Nightshadow1258/HW_STM32F405_DRV8424P/Documentation/STM32F405_DRV8424P_3DView.png

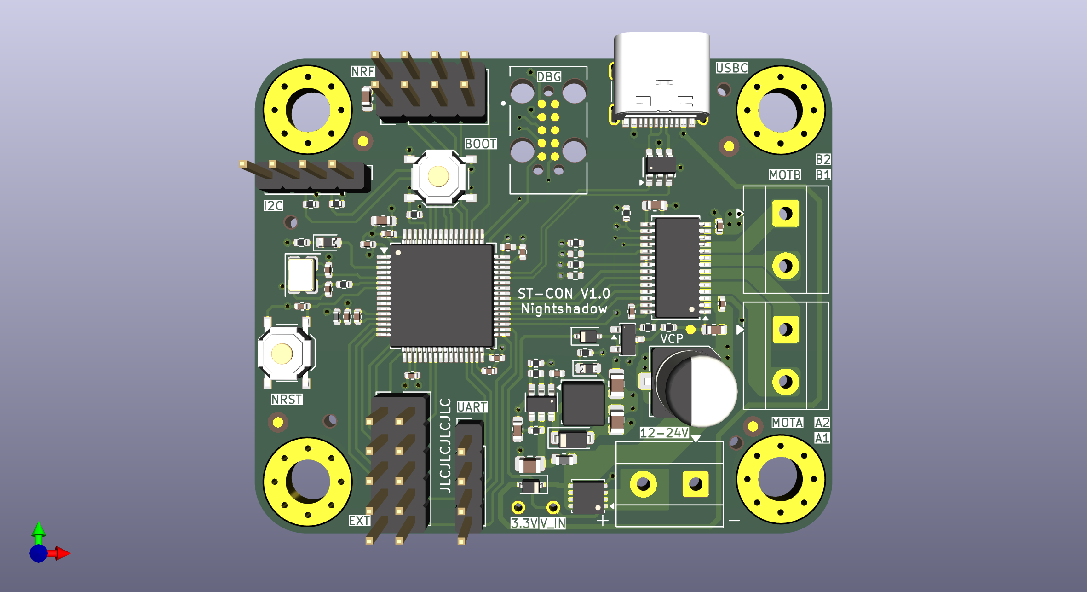
Documentation/STM32F405_DRV8424P_3DView.png
