Nightshadow1258/HW_STM32F405_DRV8424P/README.md

# STM32F405_DRV8424P
This project contains all files for a Stepper/2xDC-Motor Controller based on a STM32F405 MCU and a DRV8424P GDU.
