Nightshadow1258/HW_STM32F405_DRV8424P/Documentation/Plots/output/DRV8424_9V_(VM)_(A1).jpeg

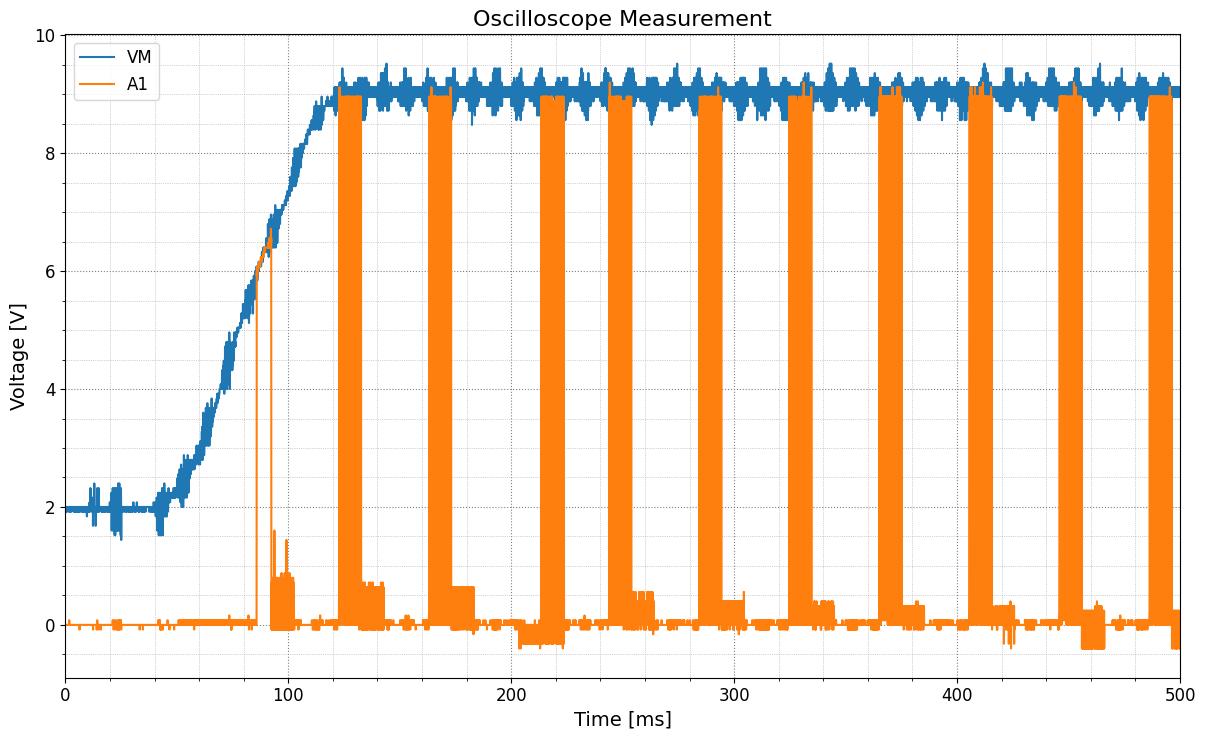
Documentation/Plots/output/DRV8424_9V_(VM)_(A1).jpeg
