Nightshadow1258/HW_STM32F405_DRV8424P/KiCAD/STM32F405_DRV8424P.step

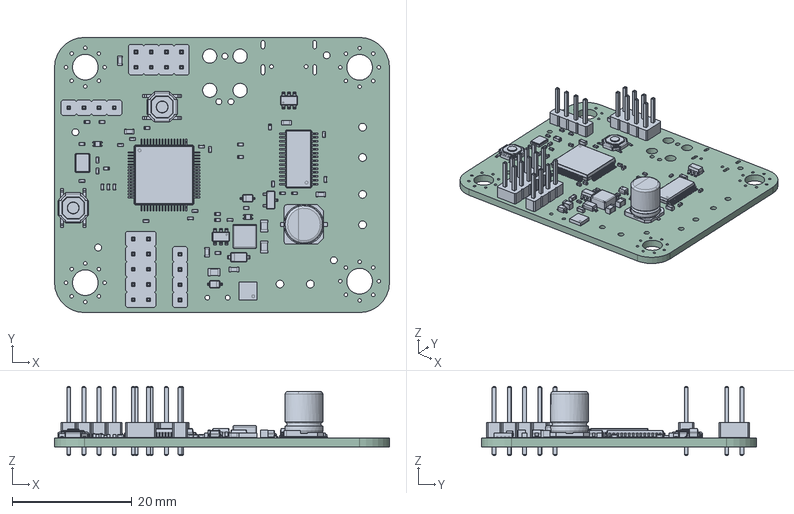
[picture p4: CAD file, 2026-08-23]
KiCAD/STM32F405_DRV8424P.step
56.0 x 46.0 x 11.5 mm
R_0402_1005Metric x 14
C_0603_1608Metric x 5
Crystal_SMD_3225-4Pin_3.2x2.5mm
C_0402_1005Metric x 16
DFN-8-1EP_3x3mm_P0.65mm_EP1.55x2.4mm
SOT-23-6 x 2
STM32F405_DRV8424P 1.11.1
PinHeader_2x05_P2.54mm_Vertical
L_0603_1608Metric
D_SOD-323 x 2
TS-1187A x 2
D_SOD-123
C_0805_2012Metric x 3
D_0603_1608Metric x 2
PinHeader_1x04_P2.54mm_Vertical x 2
CP_Elec_6.3x7.7
LQFP-64_10x10mm_P0.5mm
PinHeader_2x04_P2.54mm_Vertical
SOT-23
HTSSOP-28-1EP_4.4x9.7mm_P0.65mm_EP3.4x9.5mm
L_0402_1005Metric
STM32F405_DRV8424P_PCB
