Nightshadow1258/HW_STM32F405_DRV8424P/Documentation/Schematics/SCH_STM32F405_DRV8424P_V1.0.pdf

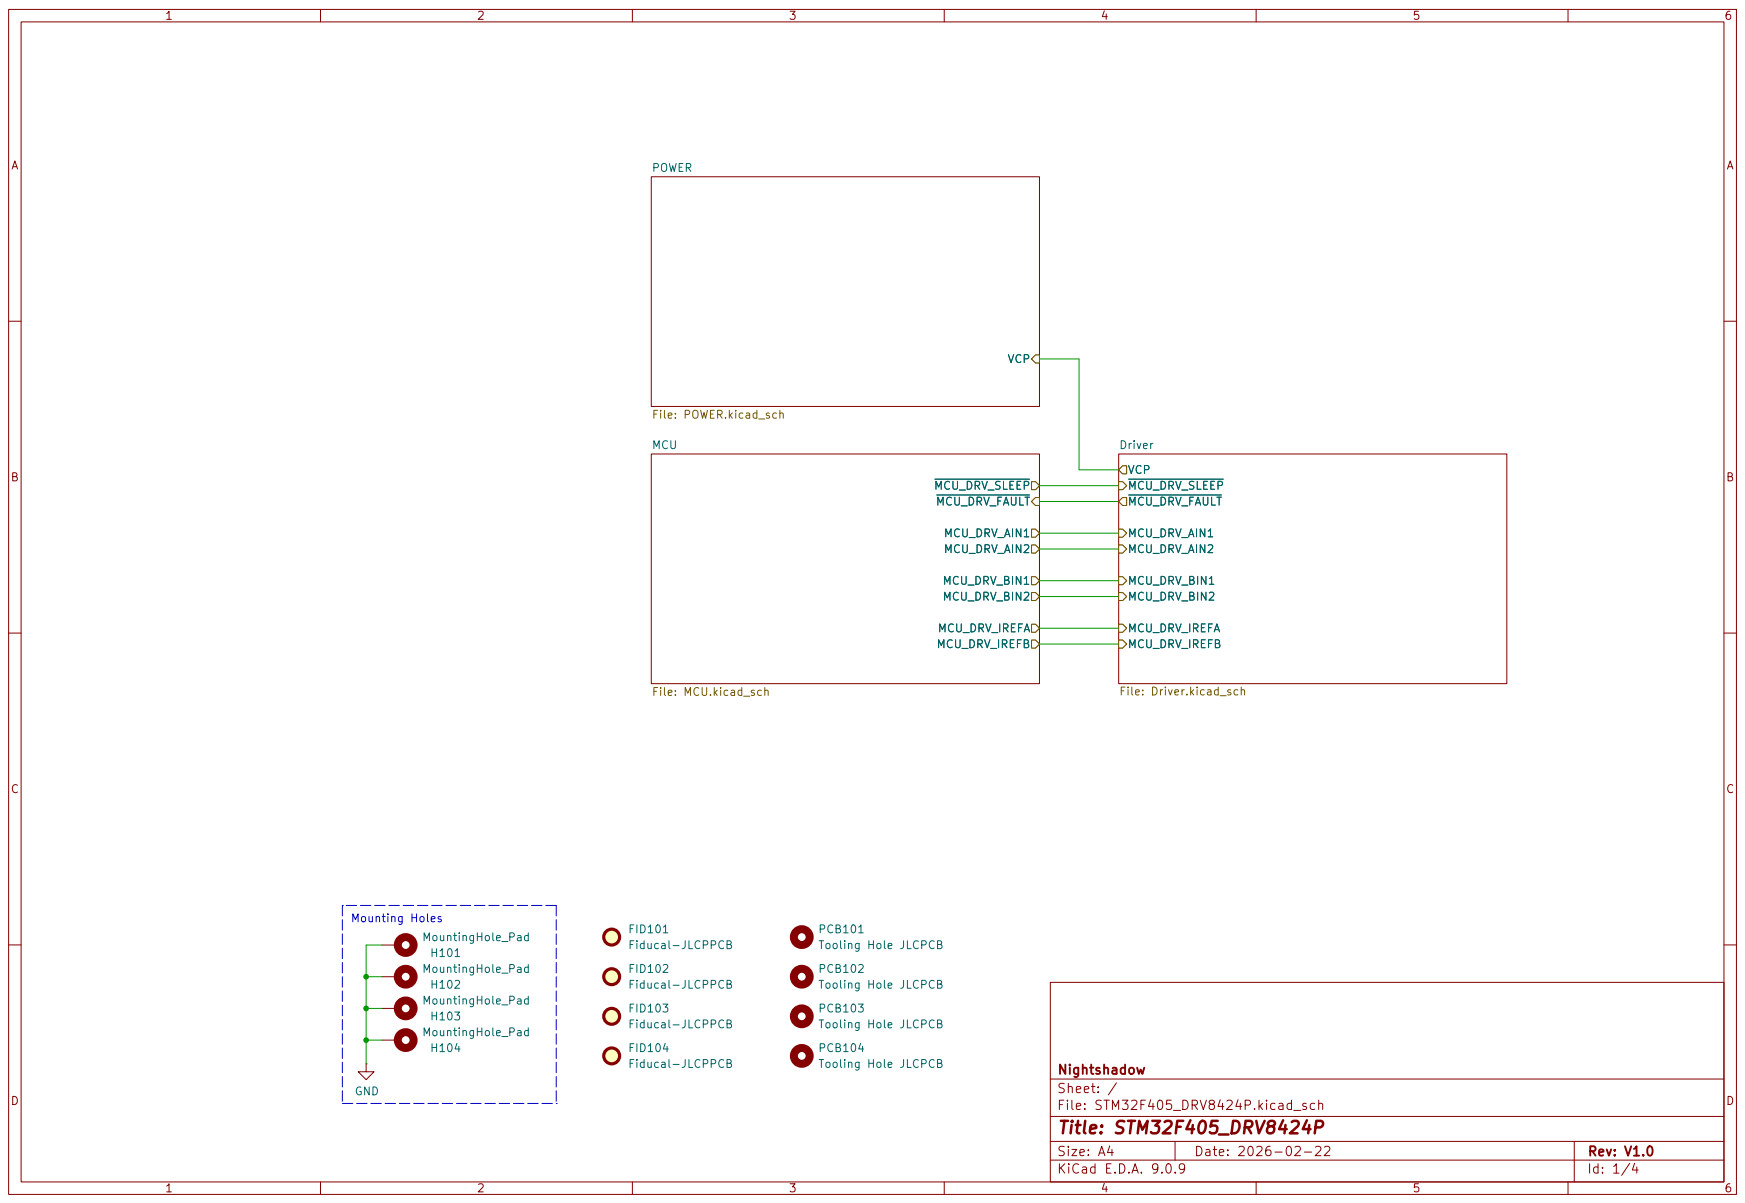
[picture p5: page 1]

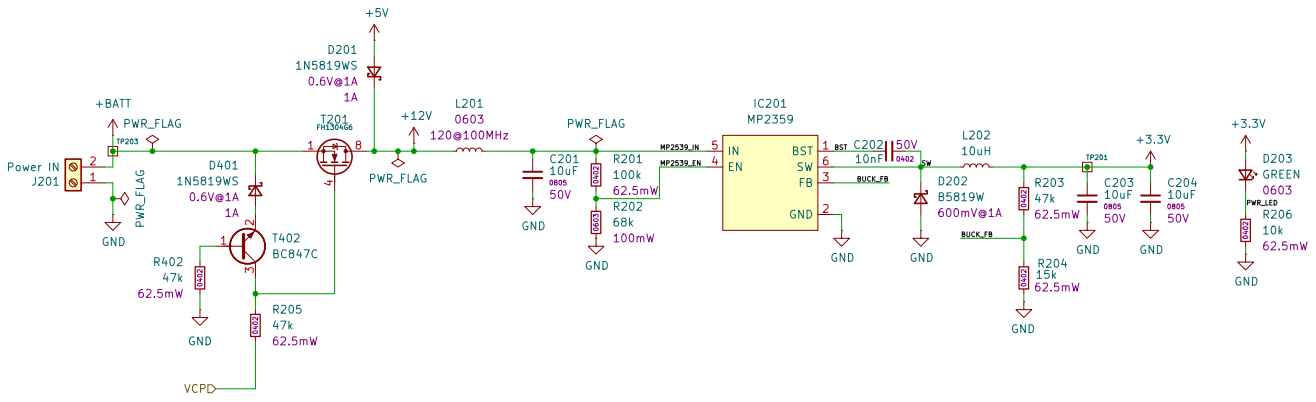
[picture p6: page 2]

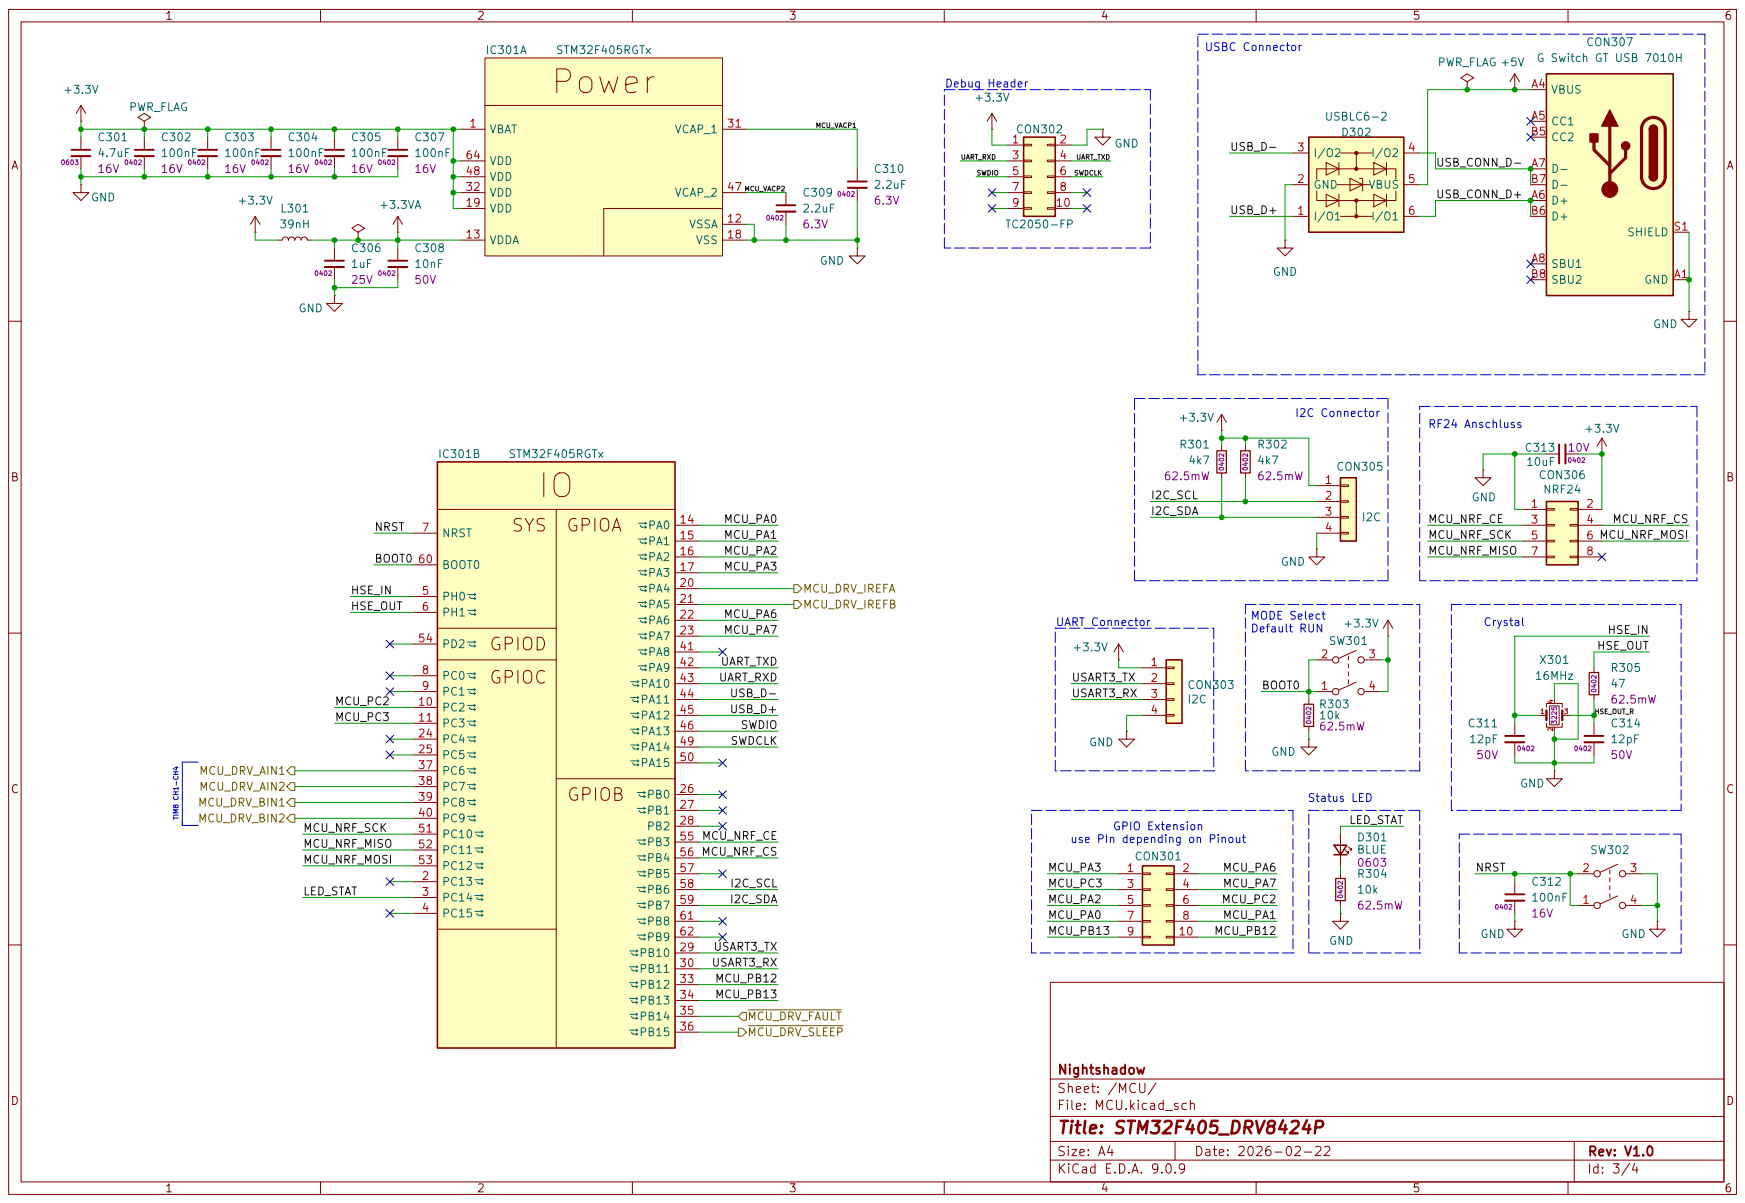
[picture p7: page 3]

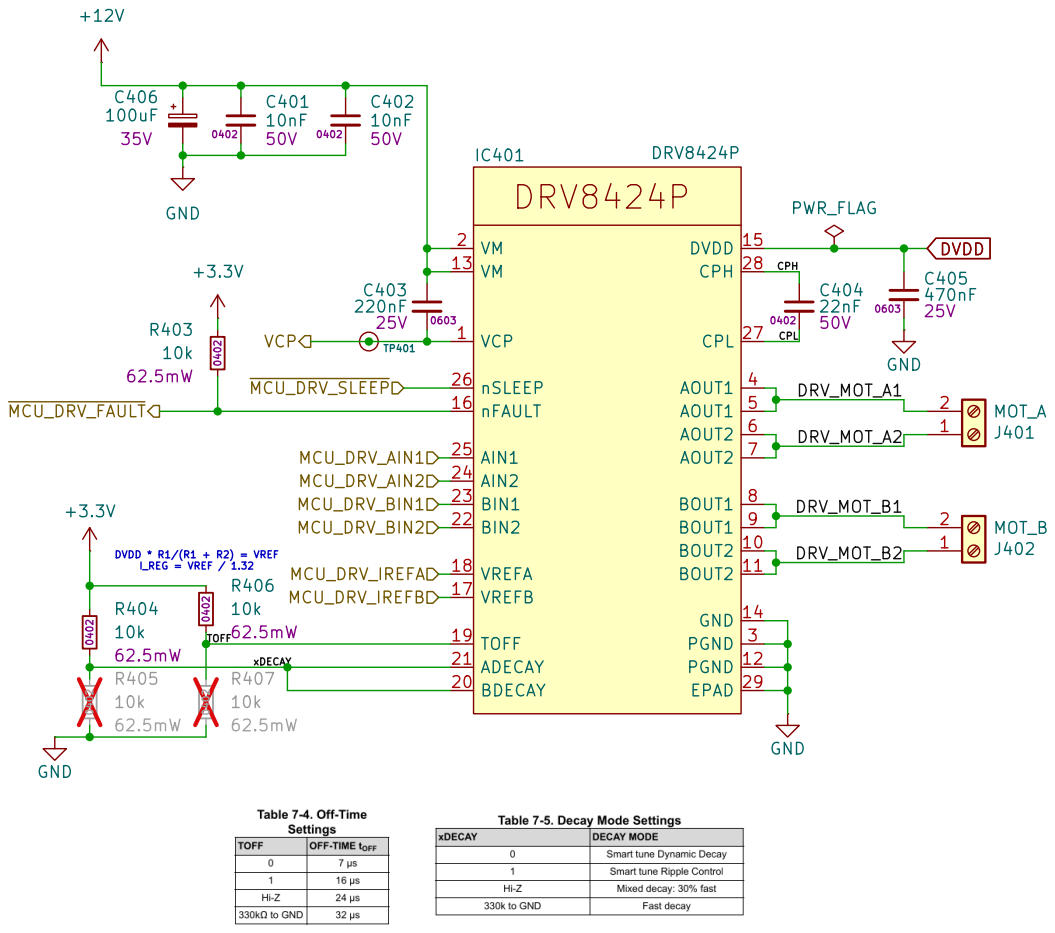
[picture p8: page 4]
