Nightshadow1258/HW_STM32F405_DRV8424P/Documentation/Plots/output/DRV8424_USBC5V_(VM)_(A1).pdf

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

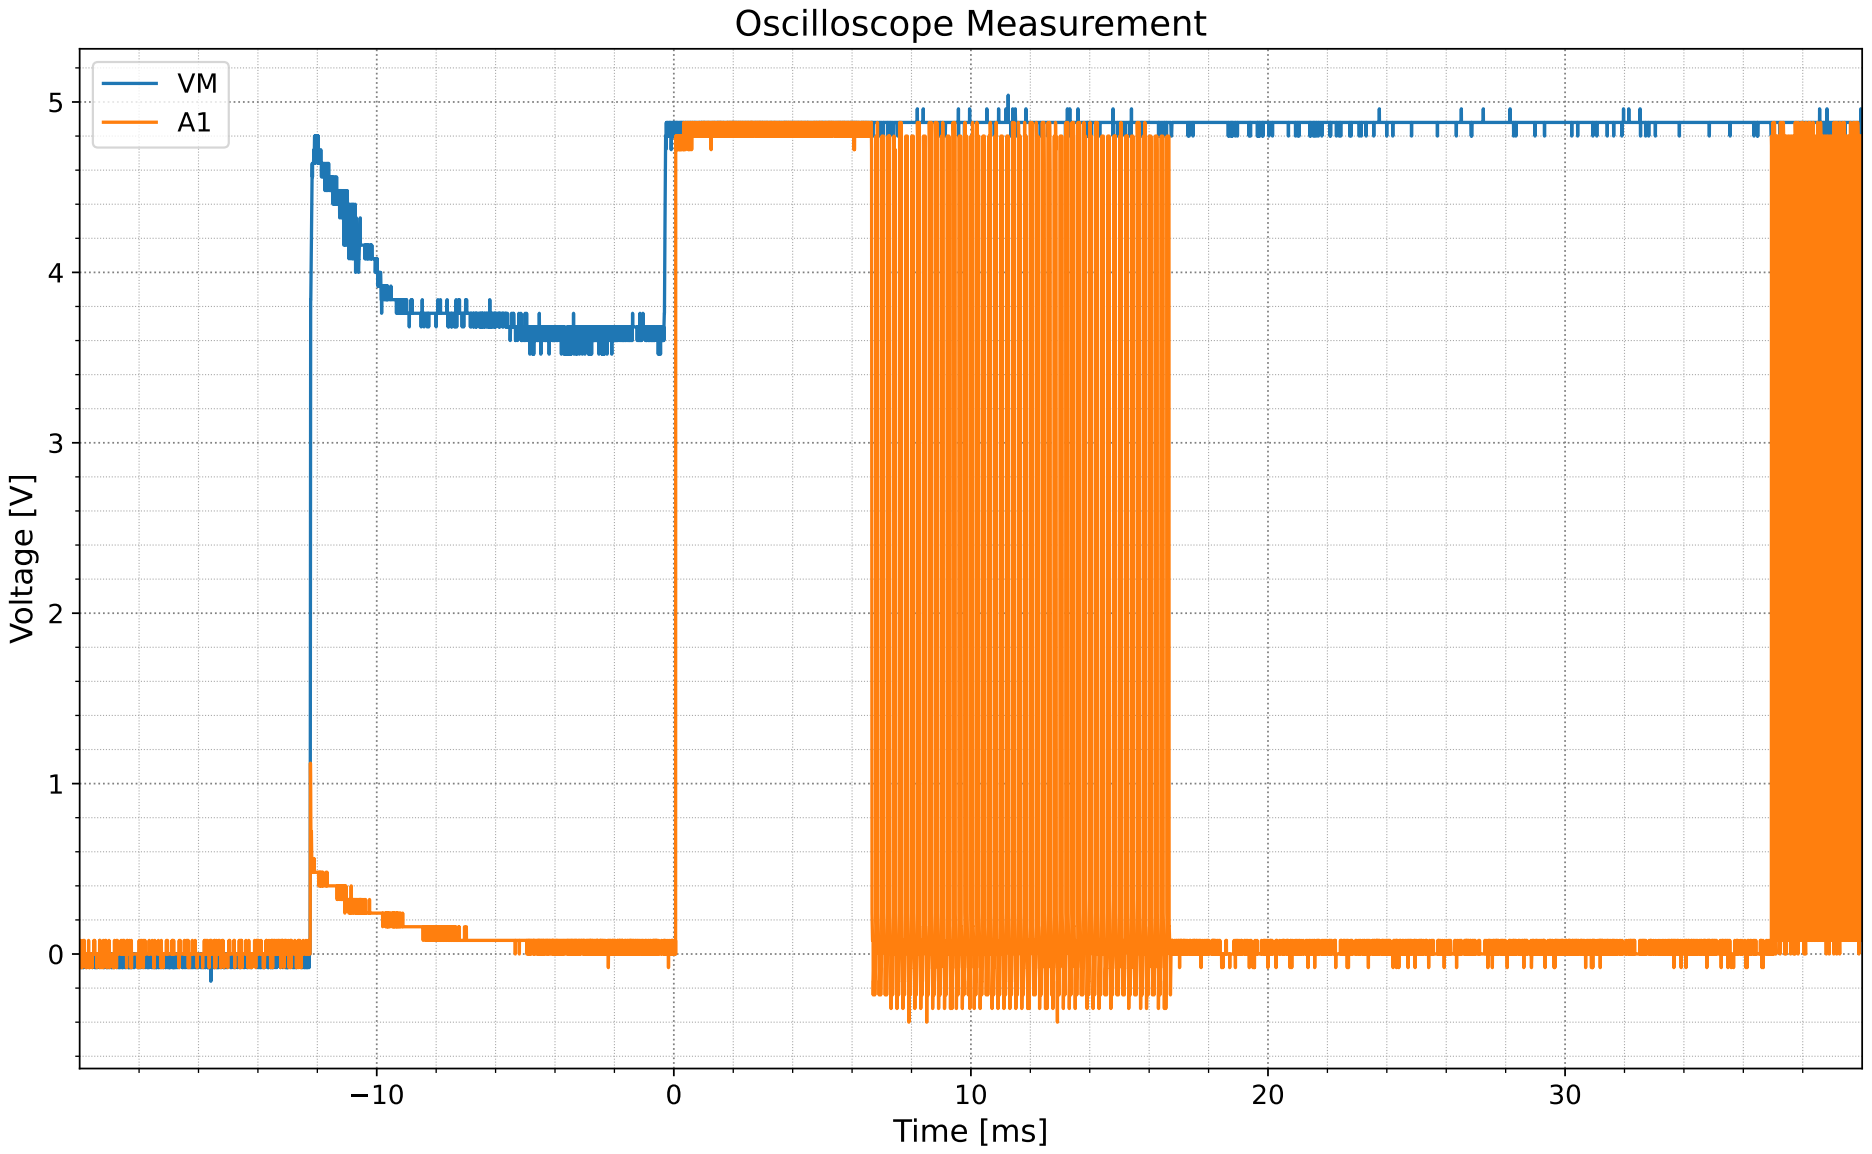
[picture p10: page 1]
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
