Nightshadow1258/HW_STM32F405_DRV8424P/KiCAD/STM32F405_DRV8424P.kicad_pcb

## KiCad design KiCAD/STM32F405_DRV8424P.kicad_pcb (2026-08-23)

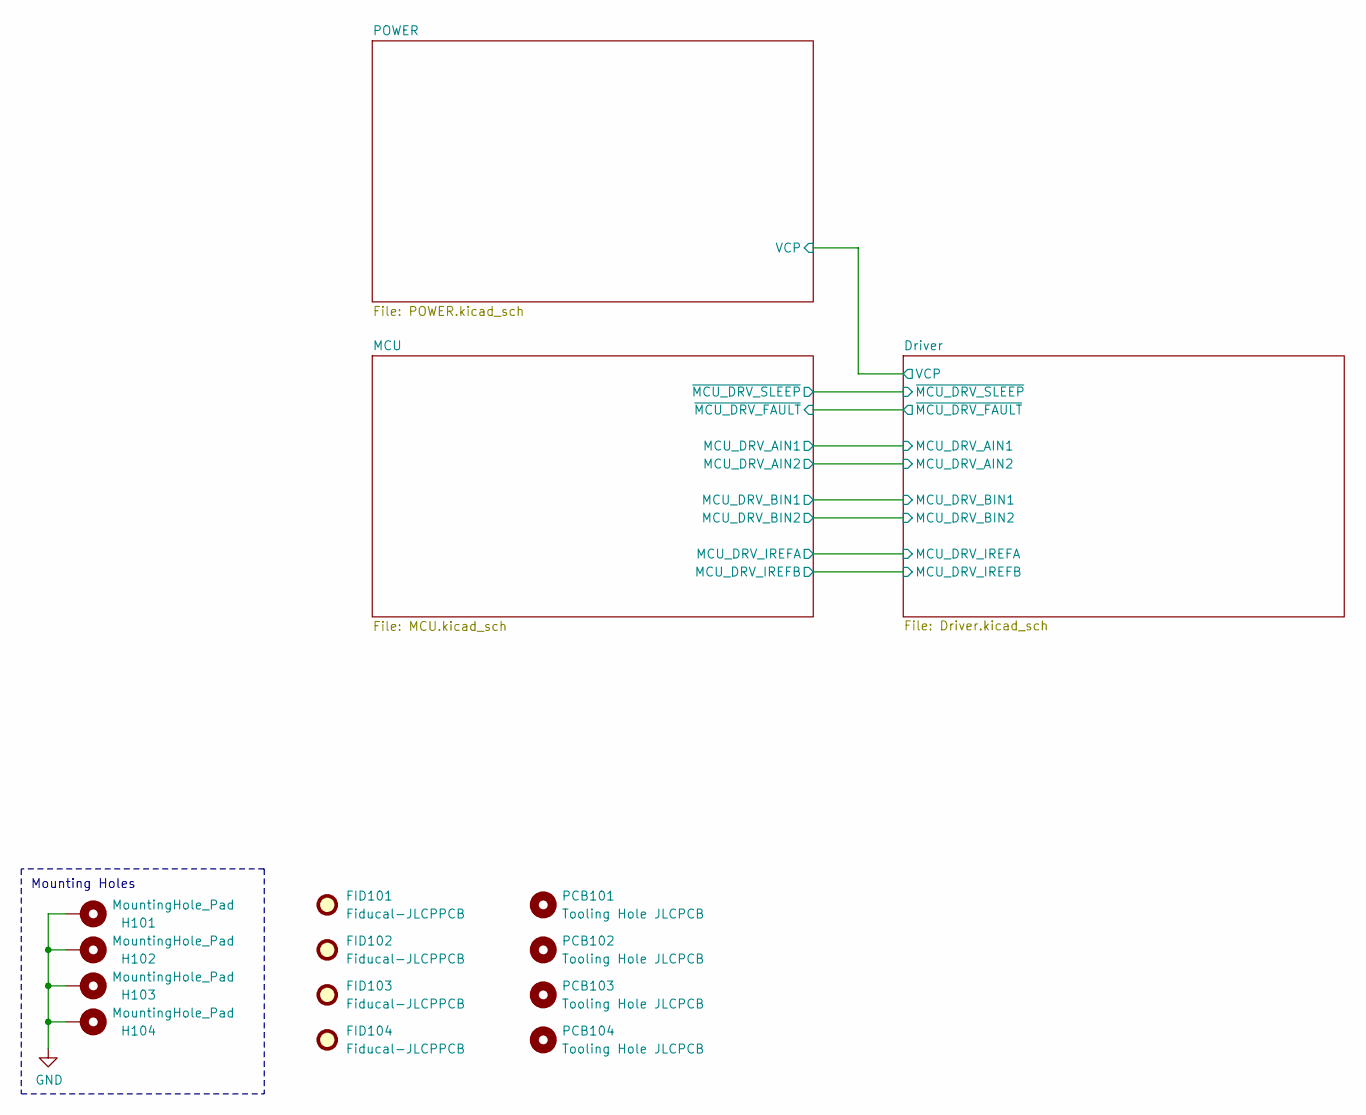
[picture p11: schematic STM32F405_DRV8424P.kicad_sch]

Parts:
FID101, FID102, FID103, FID104: Fiducal-JLCPPCB; PCB-FID-JLCPCB
H101, H102, H103, H104: MountingHole_Pad; MountingHole_4.3mm_M4_Pad_Via
PCB101, PCB102, PCB103, PCB104: Tooling Hole JLCPCB; PCB-NPTH-JLCPCB

Connections:
GND: H101.1, H102.1, H103.1, H104.1; also elsewhere on the board

Notes on the sheet:
Mounting Holes

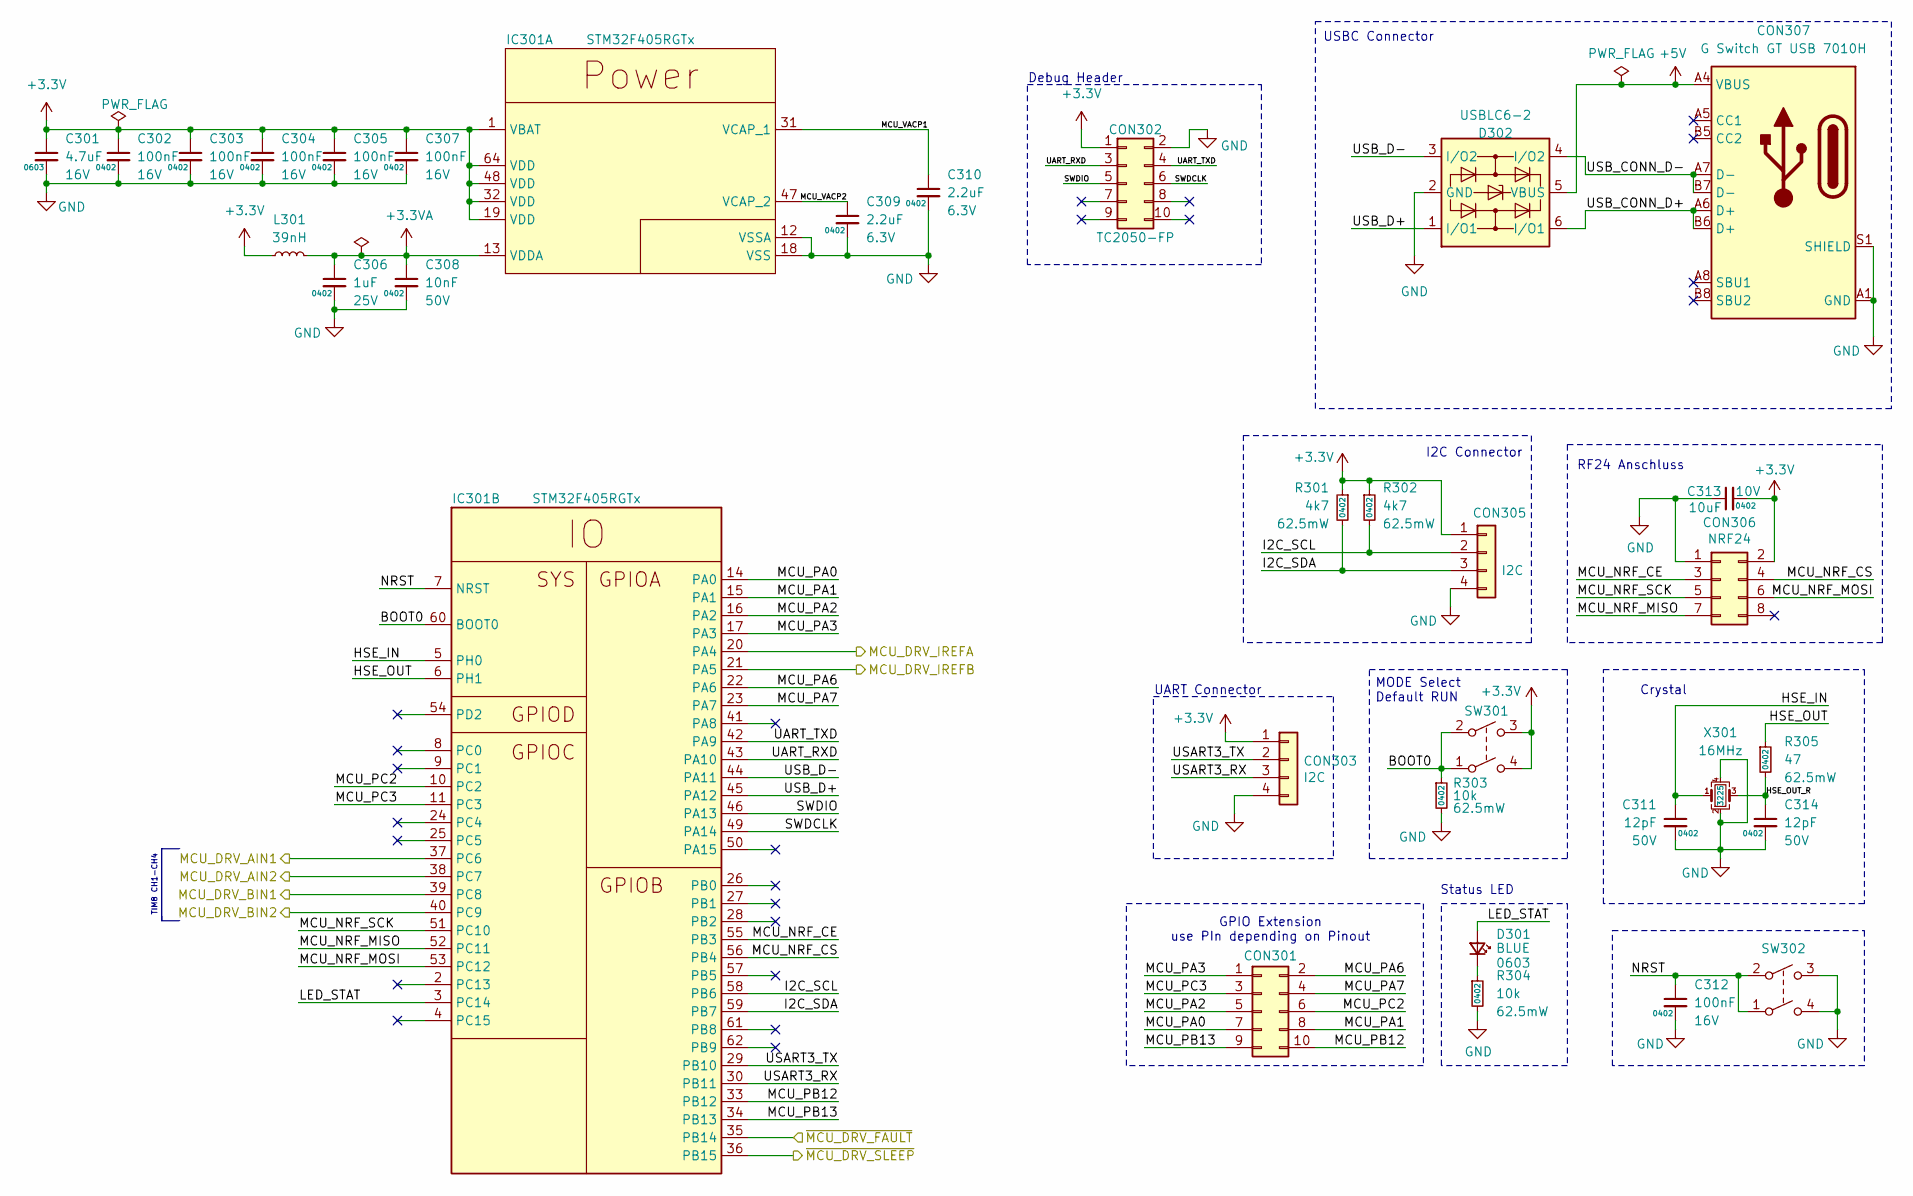
[picture p12: schematic MCU.kicad_sch, STM32F405_DRV8424P]

Parts:
C301: 4.7uF; C_0603_1608Metric; Voltage 16V; LCSC Part # C19666
C302, C303, C304, C305, C307, C312: 100nF; C_0402_1005Metric; Voltage 16V; LCSC Part # C1525
C306: 1uF; C_0402_1005Metric; Voltage 25V; LCSC Part # C52923
C308: 10nF; C_0402_1005Metric; Voltage 50V; LCSC Part # C15195
C309, C310: 2.2uF; C_0402_1005Metric; Voltage 6.3V; LCSC Part # C12530
C311, C314: 12pF; C_0402_1005Metric; Voltage 50V; LCSC Part # C1547
C313: 10uF; C_0603_1608Metric; Voltage 10V; LCSC Part # C96446
CON301: GPIO; PinHeader_2x05_P2.54mm_Vertical
CON302: TC2050-FP; CON-TAG-CONNECT_TC2050-IDC
CON303, CON305: I2C; PinHeader_1x04_P2.54mm_Vertical
CON306: NRF24; PinHeader_2x04_P2.54mm_Vertical
CON307: G Switch GT USB 7010H; CON-GEN-USB_C-16P; LCSC Part # C2988369
D301: BLUE; D_0603_1608Metric; LCSC Part # C965807
D302: USBLC6-2; SOT-23-6; LCSC Part # C7519
IC301: STM32F405RGTx; LQFP-64_10x10mm_P0.5mm; LCSC Part # C15742
L301: 39nH; L_0402_1005Metric; LCSC Part # C26443
R301, R302: 4k7; R_0402_1005Metric; Power Rating 62.5mW; LCSC Part # C25900
R303, R304: 10k; R_0402_1005Metric; Power Rating 62.5mW; LCSC Part # C25744
R305: 47; R_0402_1005Metric; Power Rating 62.5mW; LCSC Part # C25118
SW301, SW302: SW-GEN-TS-1187A; SW-PUSH-DPST-XKS-TS-1187A; LCSC Part # C318884
X301: 16MHz; Crystal_SMD_3225-4Pin_3.2x2.5mm; LCSC Part # C12668

Connections:
+3.3V: C301.1, C302.1, C303.1, C304.1, C305.1, C307.1, C313.2, CON302.1, CON303.1, CON305.1, CON306.2, IC301.1 (VBAT), IC301.19 (VDD), IC301.32 (VDD), IC301.48 (VDD), IC301.64 (VDD), L301.1, R301.1, R302.1, SW301.3 (4), SW301.4; also elsewhere on the board
+3.3VA: C306.1, C308.1, IC301.13 (VDDA), L301.2
+5V: CON307.A4 (VBUS), CON307.A9 (VBUS), CON307.B4 (VBUS), CON307.B9 (VBUS), D302.5 (VBUS); also elsewhere on the board
/Driver/MCU_DRV_AIN1: IC301.37 (PC6); also elsewhere on the board
/Driver/MCU_DRV_AIN2: IC301.38 (PC7); also elsewhere on the board
/Driver/MCU_DRV_BIN1: IC301.39 (PC8); also elsewhere on the board
/Driver/MCU_DRV_BIN2: IC301.40 (PC9); also elsewhere on the board
/Driver/MCU_DRV_IREFA: IC301.20 (PA4); also elsewhere on the board
/Driver/MCU_DRV_IREFB: IC301.21 (PA5); also elsewhere on the board
/Driver/~MCU_DRV_FAULT: IC301.35 (PB14); also elsewhere on the board
/Driver/~MCU_DRV_SLEEP: IC301.36 (PB15); also elsewhere on the board
/MCU/BOOT0: IC301.60 (BOOT0), R303.1, SW301.1, SW301.2 (3)
/MCU/HSE_IN: C311.1, IC301.5 (PH0), X301.1
/MCU/HSE_OUT: IC301.6 (PH1), R305.1
/MCU/HSE_OUT_R: C314.1, R305.2, X301.3
/MCU/I2C_SCL: CON305.2, IC301.58 (PB6), R302.2
/MCU/I2C_SDA: CON305.3, IC301.59 (PB7), R301.2
/MCU/LED_STAT: D301.2 (A), IC301.3 (PC14)
/MCU/MCU_NRF_CE: CON306.3, IC301.55 (PB3)
/MCU/MCU_NRF_CS: CON306.4, IC301.56 (PB4)
/MCU/MCU_NRF_MISO: CON306.7, IC301.52 (PC11)
/MCU/MCU_NRF_MOSI: CON306.6, IC301.53 (PC12)
/MCU/MCU_NRF_SCK: CON306.5, IC301.51 (PC10)
/MCU/MCU_PA0: CON301.7, IC301.14 (PA0)
/MCU/MCU_PA1: CON301.8, IC301.15 (PA1)
/MCU/MCU_PA2: CON301.5, IC301.16 (PA2)
/MCU/MCU_PA3: CON301.1, IC301.17 (PA3)
/MCU/MCU_PA6: CON301.2, IC301.22 (PA6)
/MCU/MCU_PA7: CON301.4, IC301.23 (PA7)
/MCU/MCU_PB12: CON301.10, IC301.33 (PB12)
/MCU/MCU_PB13: CON301.9, IC301.34 (PB13)
/MCU/MCU_PC2: CON301.6, IC301.10 (PC2)
/MCU/MCU_PC3: CON301.3, IC301.11 (PC3)
/MCU/MCU_VACP1: C310.1, IC301.31 (VCAP_1)
/MCU/MCU_VACP2: C309.1, IC301.47 (VCAP_2)
/MCU/NRST: C312.1, IC301.7 (NRST), SW302.1, SW302.2 (3)
/MCU/SWDCLK: CON302.6, IC301.49 (PA14)
/MCU/SWDIO: CON302.5, IC301.46 (PA13)
/MCU/UART_RXD: CON302.3, IC301.43 (PA10)
/MCU/UART_TXD: CON302.4, IC301.42 (PA9)
/MCU/USART3_RX: CON303.3, IC301.30 (PB11)
/MCU/USART3_TX: CON303.2, IC301.29 (PB10)
/MCU/USB_CONN_D+: CON307.A6 (D+), CON307.B6 (D+), D302.6 (I/O1)
/MCU/USB_CONN_D-: CON307.A7 (D-), CON307.B7 (D-), D302.4 (I/O2)
/MCU/USB_D+: D302.1 (I/O1), IC301.45 (PA12)
/MCU/USB_D-: D302.3 (I/O2), IC301.44 (PA11)
GND: C301.2, C302.2, C303.2, C304.2, C305.2, C306.2, C307.2, C308.2, C309.2, C310.2, C311.2, C312.2, C313.1, C314.2, CON302.2, CON303.4, CON305.4, CON306.1, CON307.A1 (GND), CON307.A12 (GND), CON307.B1 (GND), CON307.B12 (GND), CON307.S1 (SHIELD), D302.2 (GND), IC301.12 (VSSA), IC301.18 (VSS), IC301.63 (VSS), R303.2, R304.2, SW302.3 (4), SW302.4, X301.2, X301.4; also elsewhere on the board
unnamed: D301.1 (K), R304.1

Notes on the sheet:
Debug Header
GPIO Extension use PIn depending on Pinout
MODE Select Default RUN
Status LED
TIM8 CH1-CH4
UART Connector
Crystal
I2C Connector
USBC Connector
RF24 Anschluss

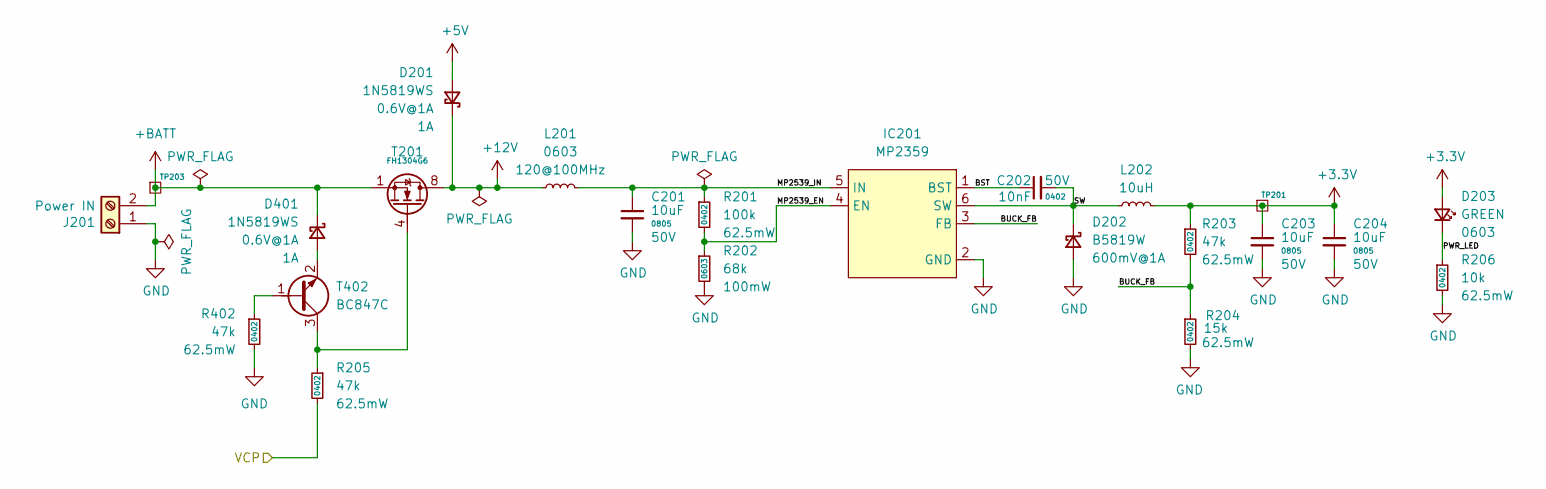
[picture p13: schematic POWER.kicad_sch, STM32F405_DRV8424P]

Parts:
C201, C203, C204: 10uF; C_0805_2012Metric; Voltage 50V; LCSC Part # C440198
C202: 10nF; C_0402_1005Metric; Voltage 50V; LCSC Part # C15195
D201, D401: 1N5819WS; D_SOD-323; LCSC Part # C191023
D202: B5819W; D_SOD-123; LCSC Part # C8598
D203: GREEN; D_0603_1608Metric; LCSC Part # C965804
IC201: MP2359; SOT-23-6; LCSC Part # C2959845
J201: Power IN; TerminalBlock_MetzConnect_Type101_RT01602HBWC_1x02_P5.08mm_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
L201: FB-BLM18PG121SN1; L_0603_1608Metric; LCSC Part # C14709
L202: 10uH; L_SXN_SMNR4020; LCSC Part # C135263
R201: 100k; R_0402_1005Metric; Power Rating 62.5mW; LCSC Part # C25741
R202: 68k; C_0603_1608Metric; Power Rating 100mW; LCSC Part # C23231
R203, R205, R402: 47k; R_0402_1005Metric; Power Rating 62.5mW; LCSC Part # C25792
R204: 15k; R_0402_1005Metric; Power Rating 62.5mW; LCSC Part # C25756
R206: 10k; R_0402_1005Metric; Power Rating 62.5mW; LCSC Part # C25744
T201: FH1304G6; DFN-8-1EP_3x3mm_P0.65mm_EP1.6x2.56mm_ThermalVias; LCSC Part # C5159042
T402: BC847C; SOT-23; LCSC Part # C8664
TP201, TP203: Testpoint-BASE; TP_THT_D0.8mm

Connections:
+3.3V: C203.1, C204.1, D203.2 (A), L202.2, R203.1, TP201.1; also elsewhere on the board
+5V: D201.2 (A); also elsewhere on the board
+12V: D201.1 (K), L201.1, T201.5 (D), T201.6 (D), T201.7 (D), T201.8 (D), T201.9 (D); also elsewhere on the board
+BATT: D401.1 (K), J201.2, T201.1 (S), T201.2 (S), T201.3 (S), TP203.1
/Driver/VCP: R205.2; also elsewhere on the board
/POWER/BST: C202.1, IC201.1 (BST)
/POWER/BUCK_FB: IC201.3 (FB), R203.2, R204.1
/POWER/MP2539_EN: IC201.4 (EN), R201.2, R202.1
/POWER/MP2539_IN: C201.1, IC201.5 (IN), L201.2, R201.1
/POWER/PWR_LED: D203.1 (K), R206.1
/POWER/SW: C202.2, D202.1 (K), IC201.6 (SW), L202.1
GND: C201.2, C203.2, C204.2, D202.2 (A), IC201.2 (GND), J201.1, R202.2, R204.2, R206.2, R402.2; also elsewhere on the board
unnamed: D401.2 (A), T402.2 (E)
unnamed: R205.1, T201.4 (G), T402.3 (C)
unnamed: R402.1, T402.1 (B)

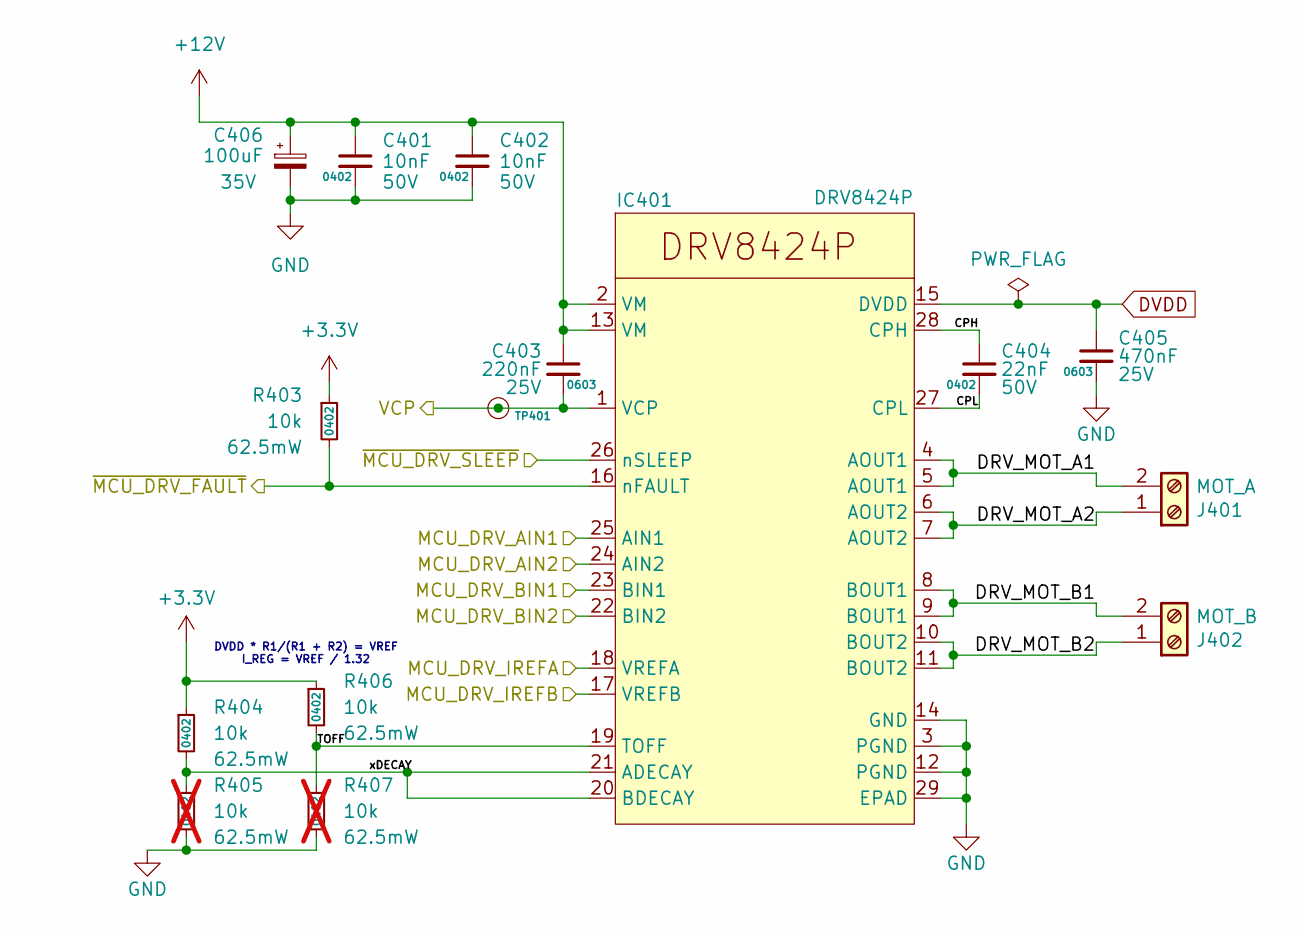
[picture p14: schematic Driver.kicad_sch, STM32F405_DRV8424P]

Parts:
C401, C402: 10nF; C_0402_1005Metric; Voltage 50V; LCSC Part # C15195
C403: 220nF; C_0603_1608Metric; Voltage 25V; LCSC Part # C21120
C404: 22nF; C_0402_1005Metric; Voltage 50V; LCSC Part # C1532
C405: 470nF; C_0603_1608Metric; Voltage 25V; LCSC Part # C1623
C406: 100uF; CP_Elec_6.3x7.7; LCSC Part # C72478
IC401: DRV8424P; HTSSOP-28-1EP_4.4x9.7mm_P0.65mm_EP3.4x9.5mm_ThermalVias; LCSC Part # C2864825
J401: MOT_A; TerminalBlock_MetzConnect_Type101_RT01602HBWC_1x02_P5.08mm_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
J402: MOT_B; TerminalBlock_MetzConnect_Type101_RT01602HBWC_1x02_P5.08mm_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
R403, R404, R406: 10k; R_0402_1005Metric; Power Rating 62.5mW; LCSC Part # C25744
R405, R407: 10k; R_0402_1005Metric; Power Rating 62.5mW; LCSC Part # C25744; not fitted
TP401: TP; TP_Pad_D0.9mm

Connections:
+3.3V: R403.1, R404.1, R406.1; also elsewhere on the board
+12V: C401.1, C402.1, C403.1, C406.1, IC401.2 (VM), IC401.13 (VM); also elsewhere on the board
/Driver/CPH: C404.1, IC401.28 (CPH)
/Driver/CPL: C404.2, IC401.27 (CPL)
/Driver/DRV_MOT_A1: IC401.4 (AOUT1), IC401.5 (AOUT1), J401.2
/Driver/DRV_MOT_A2: IC401.6 (AOUT2), IC401.7 (AOUT2), J401.1
/Driver/DRV_MOT_B1: IC401.8 (BOUT1), IC401.9 (BOUT1), J402.2
/Driver/DRV_MOT_B2: IC401.10 (BOUT2), IC401.11 (BOUT2), J402.1
/Driver/MCU_DRV_AIN1: IC401.25 (AIN1); also elsewhere on the board
/Driver/MCU_DRV_AIN2: IC401.24 (AIN2); also elsewhere on the board
/Driver/MCU_DRV_BIN1: IC401.23 (BIN1); also elsewhere on the board
/Driver/MCU_DRV_BIN2: IC401.22 (BIN2); also elsewhere on the board
/Driver/MCU_DRV_IREFA: IC401.18 (VREFA); also elsewhere on the board
/Driver/MCU_DRV_IREFB: IC401.17 (VREFB); also elsewhere on the board
/Driver/TOFF: IC401.19 (TOFF), R406.2, R407.1
/Driver/VCP: C403.2, IC401.1 (VCP), TP401.1; also elsewhere on the board
/Driver/xDECAY: IC401.20 (BDECAY), IC401.21 (ADECAY), R404.2, R405.1
/Driver/~MCU_DRV_FAULT: IC401.16 (nFAULT), R403.2; also elsewhere on the board
/Driver/~MCU_DRV_SLEEP: IC401.26 (nSLEEP); also elsewhere on the board
DVDD: C405.1, IC401.15 (DVDD)
GND: C401.2, C402.2, C405.2, C406.2, IC401.3 (PGND), IC401.12 (PGND), IC401.14 (GND), IC401.29 (EPAD), R405.2, R407.2; also elsewhere on the board

Notes on the sheet:
DVDD * R1/(R1 + R2) = VREF I_REG = VREF / 1.32

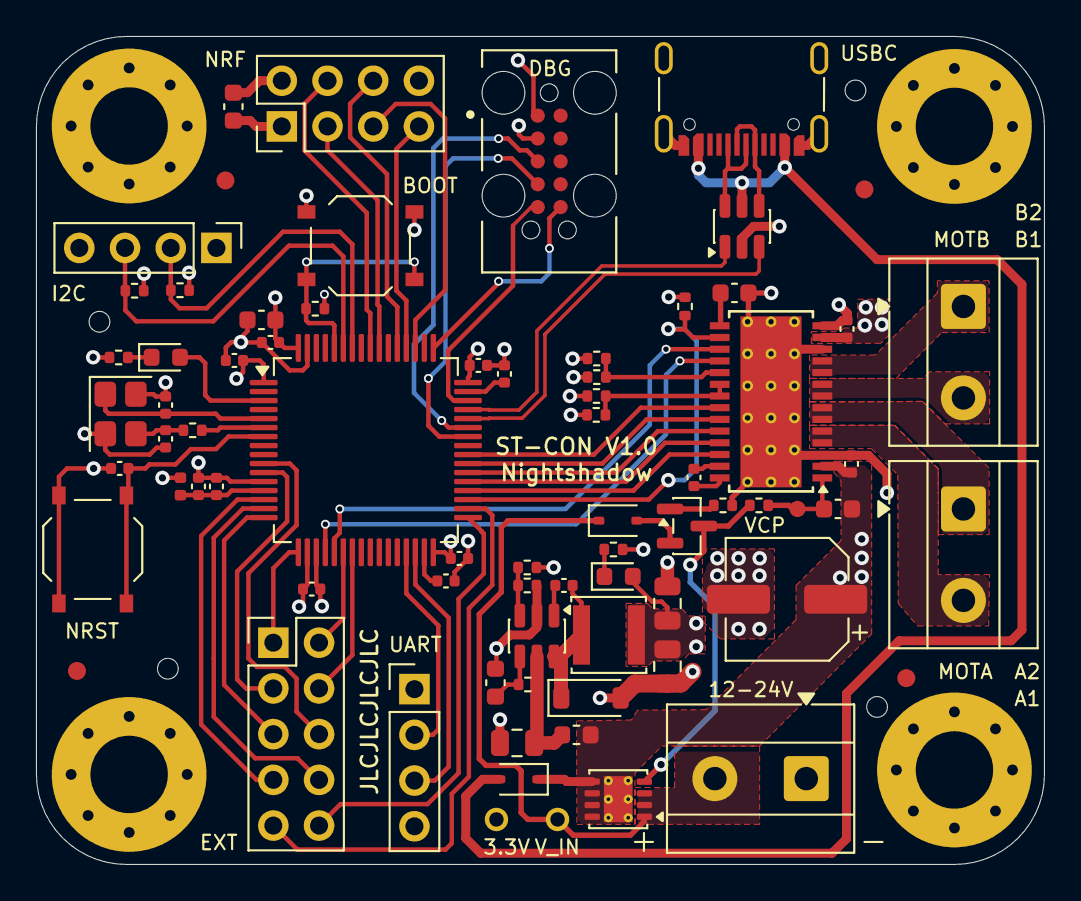
[picture p15: board STM32F405_DRV8424P.kicad_pcb from above]

Board: 4 copper layers, 56.0 x 46.0 mm, 82 parts (0 on the bottom side), 69 nets.
