Nightshadow1258/HW_STM32F405_DRV8424P/Documentation/Documentation.ioc

Mcu.UserName=STM32F405RGTx
PA10.Signal=USART1_RX
PA11.Signal=USB_OTG_FS_DM
PA12.Signal=USB_OTG_FS_DP
PA13.Signal=SYS_JTMS-SWDIO
PA14.Signal=SYS_JTCK-SWCLK
PA15.Signal=SPI3_NSS
PA4.Signal=COMP_DAC1_group
PA5.Signal=COMP_DAC2_group
PA9.Signal=USART1_TX
PB10.Signal=USART3_TX
PB11.Signal=USART3_RX
PB12.Signal=SPI2_NSS
PB13.Signal=SPI2_SCK
PB6.Signal=I2C1_SCL
PB7.Signal=I2C1_SDA
PC10.Signal=SPI3_SCK
PC11.Signal=SPI3_MISO
PC12.Signal=SPI3_MOSI
PC2.Signal=SPI2_MISO
PC3.Signal=SPI2_MOSI
PC6.Signal=S_TIM8_CH1
PC7.Signal=S_TIM8_CH2
PC8.Signal=S_TIM8_CH3
PC9.Signal=S_TIM8_CH4
PH0-OSC_IN.Signal=RCC_OSC_IN
PH1-OSC_OUT.Signal=RCC_OSC_OUT
