Nightshadow1258/HW_STM32F405_DRV8424P/(commit log)

2026-02-22 Production Ready V1.0
    [Driver.kicad_sch, MCU.kicad_sch, POWER.kicad_sch, STM32F405_DRV8424P.kicad_pcb, STM32F405_DRV8424P.kicad_sch, STM32F405_DRV8424P.sch, STM32F405_DRV8424P_V1.0_bom.csv, STM32F405_DRV8424P_V1.0_designators.csv]
2026-08-23 Added Exports and Data plots.
    [DRV8424P_comparision.ods, DRV8424_9V_(VM)_(A1).csv, DRV8424_USBC5V_(VM)_(A1).csv, STM32F405_DRV8424P.kicad_pcb, STM32F405_DRV8424P.step]
